Sverdfisk/Wind-turbine-RPM-estimation-software/(list of files, drawings)

Other design files:
altium_files/Component Library.SchLib
altium_files/IMX385/IMX385_Final.PrjPcb
altium_files/IMX385/IMX_1.2V Digital Power Supply.SchDoc
altium_files/IMX385/IMX_1.8 V Interface Power Supply.SchDoc
altium_files/IMX385/IMX_3.3 V Analog Power Supply.SchDoc
altium_files/IMX385/IMX_Analog Interface Circuit.SchDoc
altium_files/IMX385/IMX_Digital Interface Circuit.SchDoc
altium_files/IMX385/IMX_Output Circuit.SchDoc
altium_files/IMX385/IMX_PCB.PcbDoc
altium_files/IMX385/IMX_Power Regulation.SchDoc
altium_files/IMX385/IMX_Supporting Circuits.SchDoc
altium_files/PCB Library.PcbLib
