Sverdfisk/Wind-turbine-RPM-estimation-software/driver/config.txt

# For more options and information see
# http://rptl.io/configtxt
# Some settings may impact device functionality. See link above for details

# Uncomment some or all of these to enable the optional hardware interfaces
dtparam=i2c_arm=on
#dtparam=i2s=on
#dtparam=spi=on
dtparam=i2c0=on
dtparam=i2c_csi_dsi=on
dtparam=i2c_csi_dsi0=on
dtparam=i2c_csi_dsi1=on
dtparam=cam0_reg=on
dtparam=cam1_reg=on

# Enable audio (loads snd_bcm2835)
dtparam=audio=on

# Additional overlays and parameters are documented
# /boot/firmware/overlays/README

# Automatically load overlays for detected cameras
camera_auto_detect=0

# Load imx385 camera
dtoverlay=imx385-overlay,cam1

# Load the Pi ISP
dtoverlay=pisp

# Automatically load overlays for detected DSI displays
display_auto_detect=1

# Automatically load initramfs files, if found
auto_initramfs=1

# Enable DRM VC4 V3D driver
dtoverlay=vc4-kms-v3d
max_framebuffers=2

# Don't have the firmware create an initial video= setting in cmdline.txt.
# Use the kernel's default instead.
disable_fw_kms_setup=1

# Run in 64-bit mode
arm_64bit=1

# Disable compensation for displays with overscan
disable_overscan=1

# Run as fast as firmware / board allows
arm_boost=1

[cm4]
# Enable host mode on the 2711 built-in XHCI USB controller.
# This line should be removed if the legacy DWC2 controller is required
# (e.g. for USB device mode) or if USB support is not required.
otg_mode=1

[cm5]
dtoverlay=dwc2,dr_mode=host

[all]
dtoverlay=gpio46-low
gpio=46=op,dh
gpio=5=op,dl
gpio=6=op,dl
gpio=17=op,dl
gpio=25=op,dl
gpio=26=op,dl
gpio=27=op,dl
