Sverdfisk/Wind-turbine-RPM-estimation-software/(commit log)

2025-01-29 refactor flow, almost working
2025-02-06 add filtering options for magnitudes and remove unnecessary stuff
2025-02-07 added statistics printing and a lot of error handling
2025-02-10 runs n stuff
    [run_results.csv, run_results_mag_2.24_scale_check.csv, run_results_mag_2.44_scale_check.csv]
2025-02-10 more tweaks
    [run_results.csv]
2025-02-11 idk what i did
    [run_results.csv, run_results_mag_2.24_scale_check.csv, run_results_mag_2.44_scale_check.csv]
2025-02-19 fix frame update bug
2025-02-19 fixed small ground angle oopsie
2025-02-25 refactor call structure separated scripts into main.py and mutirunner.py to clean up multi-run testing cases and real case testing other small tweaks
2025-02-26 better config stuff and small tweaks to flow
2025-02-27 early stages of new mode
2025-03-07 Frame buffer and processing support Actual RPM calculation and related logic not implemented
2025-03-20 add frametime cfg
    I am very very stupid and also dumb :)))
2025-04-03 fix button
2025-04-10 add support for optical flow and further structure tweaks
2025-04-17 proper driver addition
2025-05-14 add new version of driver
2025-06-10 Add altium files
    [Component Library.SchLib, IMX385_Final.PrjPcb, IMX_1.2V Digital Power Supply.SchDoc, IMX_1.8 V Interface Power Supply.SchDoc, IMX_3.3 V Analog Power Supply.SchDoc, IMX_Analog Interface Circuit.SchDoc, IMX_Digital Interface Circuit.SchDoc, IMX_Output Circuit.SchDoc]
2025-06-10 Added BOM and Pick and Place csv files
    [IMX385-Final-BOM.csv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]
2025-06-22 remove stray driver orphan
2025-06-22 add driver files
    [config.txt]
2026-04-15 Enhance README with system details and images
    Expanded the README with information about PCB layout and sample images
